chili-chip/chili-audio-module-hardware/chili-audio-module-hardware.step

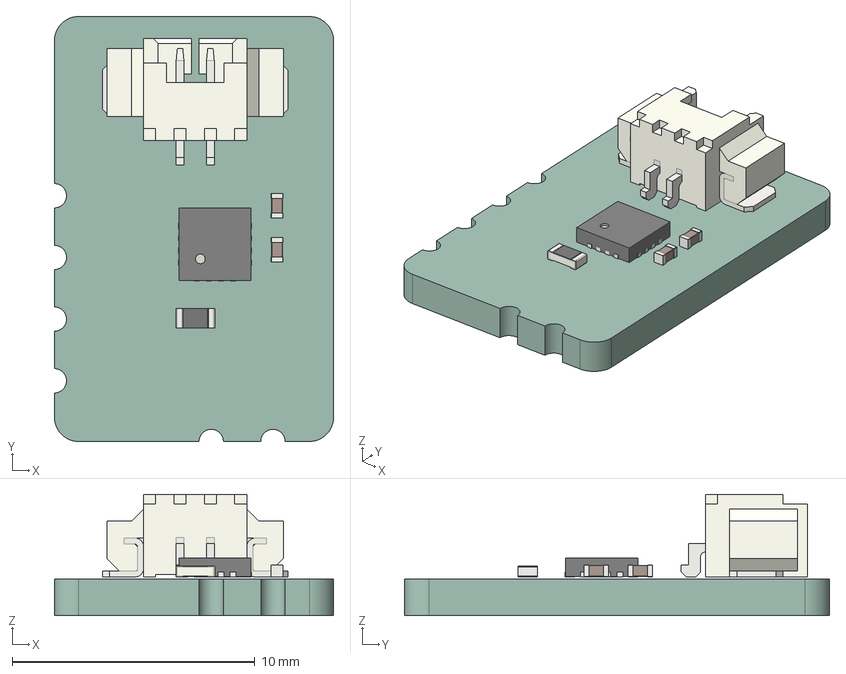
[picture p4: CAD file, 2026-11-05]
chili-audio-module-hardware.step
11.5 x 17.5 x 5.00 mm
Molex_53261_0271
C_0402_1005Metric x 2
R_0603_1608Metric
TQFN_16_1EP_3x3mm_P05mm_EP16x16mm
chili-audio-module-hardware_PCB
