chili-chip/chili-audio-module-hardware/chili-audio-module-hardware.kicad_pcb

## KiCad design chili-audio-module-hardware.kicad_pcb (2026-11-05)

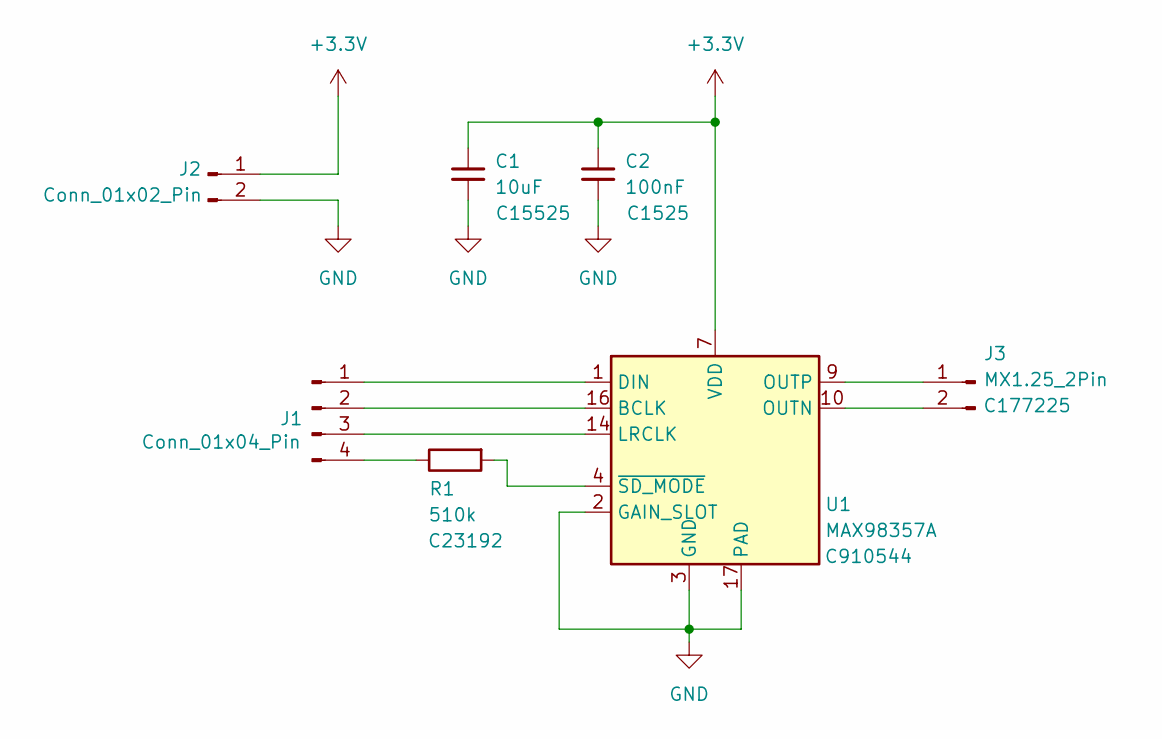
[picture p5: schematic chili-audio-module-hardware.kicad_sch, CHILICHIP AUDIO MODULE]

Parts:
C1: 10uF; C_0402_1005Metric; LCSC C15525
C2: 100nF; C_0402_1005Metric; LCSC C1525
J1: Conn_01x04_Pin; Castellated_1x04_P2.54mm
J2: Conn_01x02_Pin; Castellated_1x02_P2.54mm
J3: MX1.25_2Pin; Molex_PicoBlade_53261-0271_1x02-1MP_P1.25mm_Horizontal; LCSC C177225
R1: 510k; R_0603_1608Metric; LCSC C23192
U1: MAX98357A; TQFN-16-1EP_3x3mm_P0.5mm_EP1.23x1.23mm_ThermalVias; LCSC C910544

Connections:
+3.3V: C1.1, C2.1, J2.1, U1.7 (VDD), U1.8 (VDD)
GND: C1.2, C2.2, J2.2, U1.2 (GAIN_SLOT), U1.3 (GND), U1.11 (GND), U1.15 (GND), U1.17 (PAD)
unnamed: J1.1, U1.1 (DIN)
unnamed: J1.2, U1.16 (BCLK)
unnamed: J1.3, U1.14 (LRCLK)
unnamed: J1.4, R1.1
unnamed: J3.1, U1.9 (OUTP)
unnamed: J3.2, U1.10 (OUTN)
unnamed: R1.2, U1.4 (~SD_MODE)

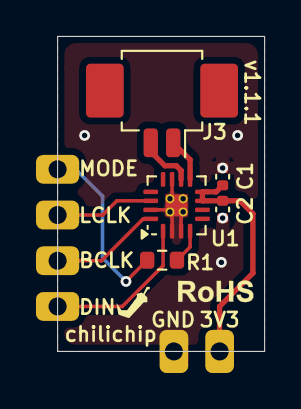
[picture p6: board chili-audio-module-hardware.kicad_pcb from above]

Board: 2 copper layers, 11.5 x 17.5 mm, 8 parts (0 on the bottom side), 9 nets.

Other parts of the board:
ROHS: RoHS-Logo_6mm_SilkScreen
