chili-chip/chili-audio-module-hardware/(commit log)

2026-10-23 schematic done
    [chili-audio-module-hardware.kicad_pcb, chili-audio-module-hardware.kicad_sch]
2026-10-23 schematic finished with parts chosen
    [chili-audio-module-hardware.kicad_sch]
2026-10-23 pcb design
    [chili-audio-module-hardware.kicad_pcb, chili-audio-module-hardware.kicad_sch]
2026-10-26 Add KiCad 10 CI and release workflow (#1)
2026-10-27 finishing touches
    [chili-audio-module-hardware.kicad_pcb]
2026-10-27 small correction
    [chili-audio-module-hardware.kicad_pcb]
2026-11-05 Castellated edge pads, front silkscreen, v1.1.0 (#2)
    * Castellated edge pads, front silkscreen, v1.1.0
    - Replace the J1/J2 2.54mm pin headers with castellated (plated
    half-hole) edge pads on the left and bottom board edges. Same pin
    order, nets and pitch; pads moved 2.5mm out onto the board edge.
    New footprints in the project library chili-audio-module.pretty.
    - Reroute J1 pin 4 (MODE) via B.Cu, since its old track ran where the
    edge pads now sit. Extend the other header tracks to the new pads.
    - J1/J2 excluded from BOM and position files (no part to place).
    - Move back silkscreen artwork (logo, RoHS, chilichip, version) to the
    front and relocate pin labels clear of the new pads.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
    [chili-audio-module-hardware.kicad_pcb, chili-audio-module-hardware.kicad_sch, chili-audio-module-hardware.step]
2026-11-05 v1.1.1: README, JLCPCB release files, silkscreen stroke fix (#3)
    * Thicken thin silkscreen text to 0.15mm for fab
    chilichip, v1.1.0 and chili-audio-module used a 0.1mm stroke, below
    JLCPCB's ~0.15mm minimum silkscreen line width. Match the 0.15mm used by
    the pin labels and reference designators.
    * CI: build JLCPCB fab and assembly files, attach to releases
    Add scripts/export-jlcpcb.sh, which exports a gerber/drill zip, a BOM
    (Comment, Designator, Footprint, LCSC Part #) and a CPL (Designator,
    Mid X, Mid Y, Layer, Rotation) in JLCPCB's formats. A new jlcpcb CI job
    runs it in the kicad/kicad:10.0.7 image on every push and PR and
    uploads the files as an artifact; the release job attaches the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
    [chili-audio-module-hardware.kicad_pcb, chili-audio-module-hardware.kicad_sch]
